HaiVuQuang/IPS_Firefighting_training_system/Documents/VuQuangNhatHai/DATN_VQNH_report_slide.pdf

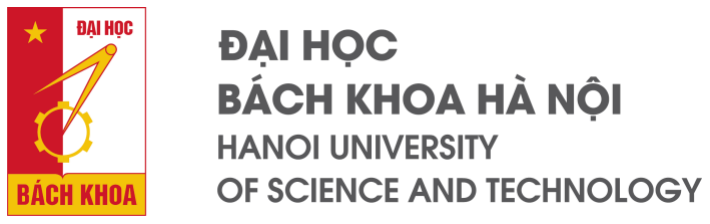
[picture p79: figure]

# THIẾT KẾ HỆ THỐNG HUẤN LUYỆN CHỮA CHÁY TRONG MÔI TRƯỜNG ẢO ỨNG DỤNG CÁC KỸ THUẬT ĐỊNH VỊ TRONG NHÀ

### Sinh viên: Vũ Quang Nhật Hải MSSV: 20222125 GVHD: TS. Hoàng Đức Chính

2

## Đề tài:

## MỤC LỤC

## 1. Tổng quan đề tài

## 2. Cơ sở lý thuyết và thuật toán định vị

## 3. Thiết kế - phát triển hệ thống

## 4. Thực nghiệm - đánh giá

## 5. Kết luận - Hướng phát triển

3

I.

# Tổng quan đề tài

## 1. TỔNG QUAN ĐỀ TÀI

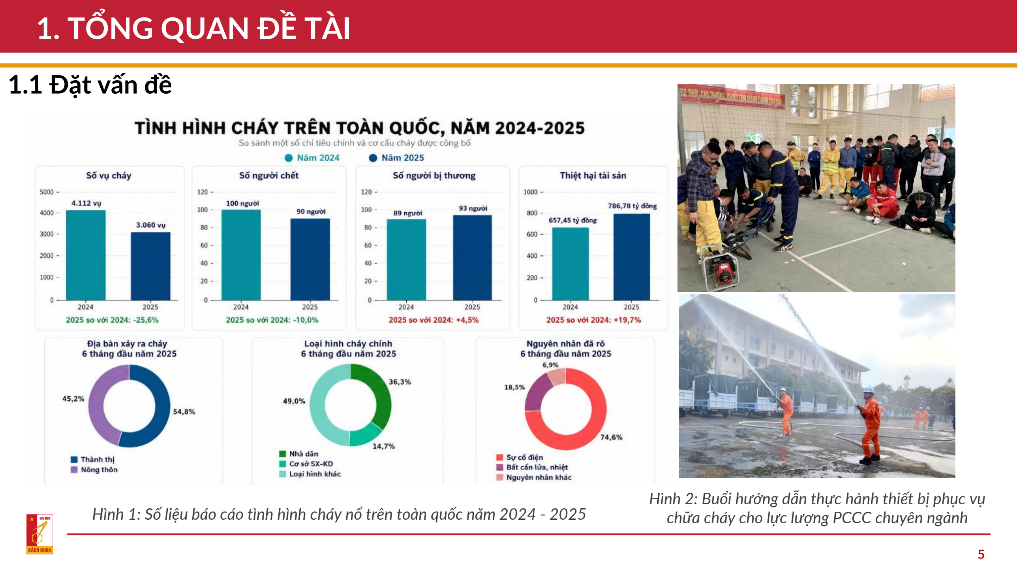
[picture p80: page 5]

5

### 1.1 Đặt vấn đề

Hình 1: Số liệu báo cáo tình hình cháy nổ trên toàn quốc năm 2024 - 2025

Hình 2: Buổi hướng dẫn thực hành thiết bị phục vụ chữa cháy cho lực lượng PCCC chuyên ngành

## 1. TỔNG QUAN ĐỀ TÀI

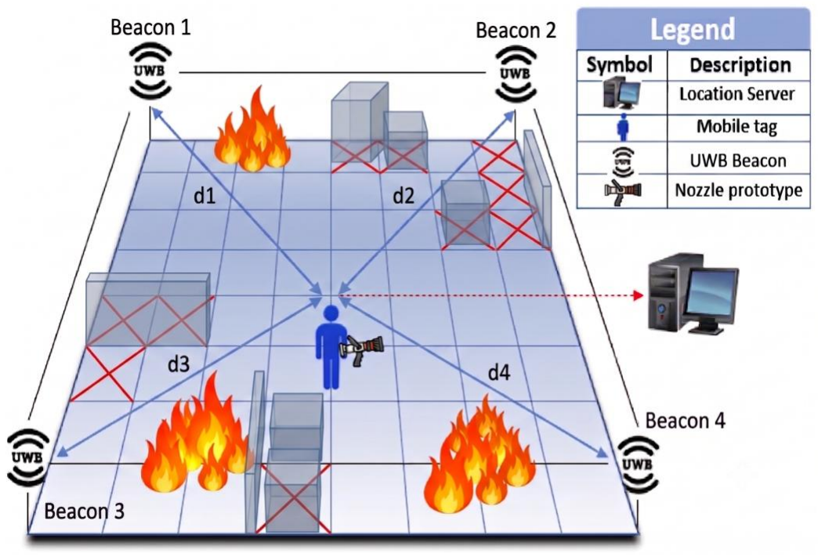
[picture p81: figure]

6

### 1.2 Mục tiêu và phạm vi đề tài

- Mục tiêu: Thiết kế, triển khai và thử nghiệm một hệ thống hỗ trợ huấn luyện chữa cháy dựa trên nền tảng mô phỏng
- Phạm vi đề tài:
- Nghiên cứu giải pháp theo dõi – định vị liên tục tọa độ quỹ đạo học viên theo thời gian thực
- Phát triển Prototype phần cứng dựa theo thiết bị chữa cháy thực tế, tích hợp cảm biến và cơ cấu chấp hành nhằm số hóa thao tác, phục vụ huấn luyện
- Xây dựng nền tảng phần mềm với các công cụ quản lý
tập trung giúp huấn luyện viên số hóa bản đồ, thiết
lập kịch bản huấn luyện và giám sát, đánh giá kết quả. | Hình 3: Sơ đồ ý tưởng thiết kế cho hệ thống huấn luyện mô phỏng

II.

# Cơ sở lý thuyết và thuật toán định vị

## 2. CƠ SỞ LÝ THUYẾT VÀ THUẬT TOÁN ĐỊNH VỊ

8

### 2.1 Thuật toán định vị đề xuất

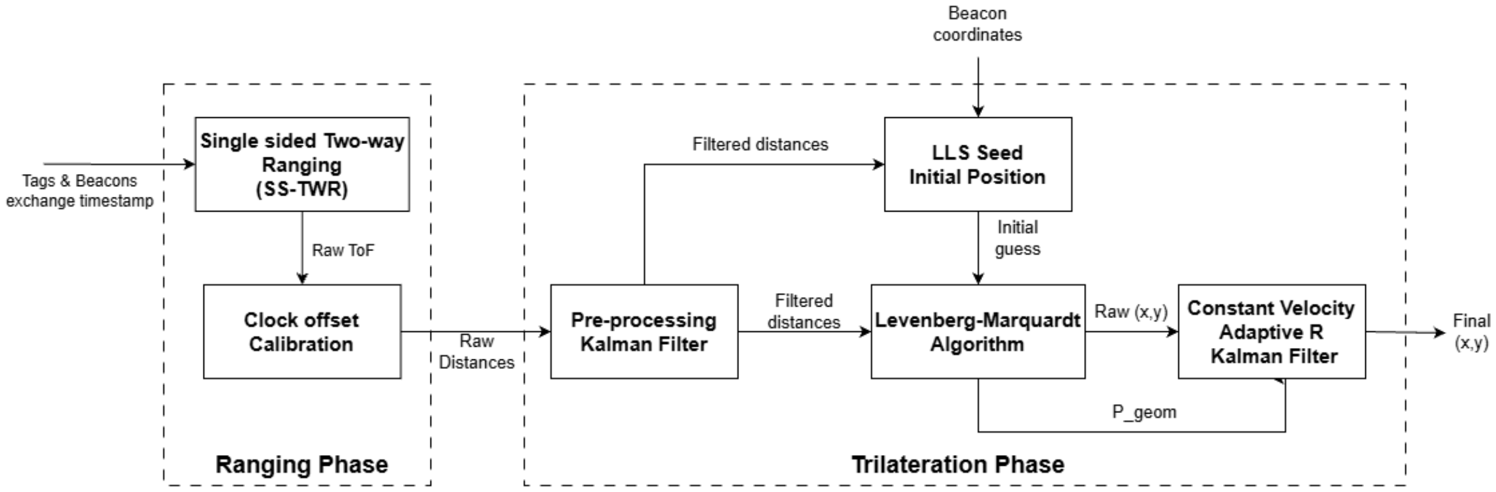
[picture p82: figure]

Hình 4: Các giai đoạn xử lý dữ liệu trong kiến trúc thuật toán định vị đề xuất

## 2. CƠ SỞ LÝ THUYẾT VÀ THUẬT TOÁN ĐỊNH VỊ

9

### 2.2 Kỹ thuật định tầm Single sided Two-way Ranging (SS-TWR)

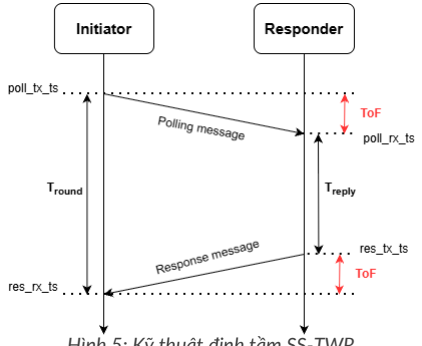
[picture p83: figure]

ClockOffsetRatio = carrier_integ ×

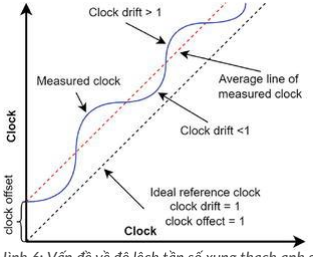
[picture p84: figure]

FREQ_OFFSET × HERTZ_TO_PPM_MULTIPLIER 1.0 × 10⁶

ToF =

resp_rx_ts − poll_tx_ts − resp_tx_ts − poll_rx_ts × 1.0 − ClockOffsetRatio 2

Hình 5: Kỹ thuật định tầm SS-TWR

Hình 6: Vấn đề về độ lệch tần số xung thạch anh giữa thiết bị phát/ thu

## 2. CƠ SỞ LÝ THUYẾT VÀ THUẬT TOÁN ĐỊNH VỊ

10

❖ Pha Dự báo (State Prediction):
- Dự báo trạng thái:
X෠

k|k−1 = F . X෠
k−1|k−1
- Dự báo ma trận sai số:
P෠

k|k−1 = F .X෠
k−1|k−1. F

T + Q
❖ Pha Cập nhật (Update Phase):
Đo đạc dữ liệu khoảng cách thô zk ở chu kỳ hiện tại để hiệu chỉnh lại dự báo.
- Kalman Gain:

Kk =

Pk|k−1.H

T
(H. Pk|k−1.HT) + R
- Cập nhật trạng thái:
X෠

k|k = X෠

k|k−1 − Kk. (zk − H. X෠
k|k−1)
- Cập nhật ma trận sai số:
P෠

k|k = (I − Kk.H). P෠
k|k−1

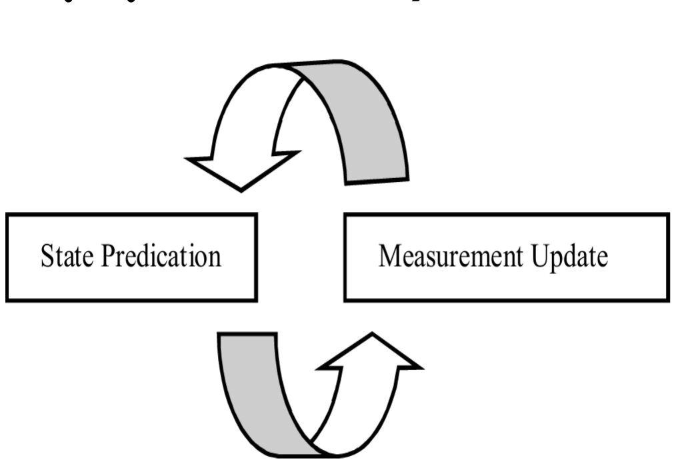
[picture p85: figure]

❖ Mô hình toán học :

Xk =

dk
dሶ
k

, F =

1 Δt
0 1

,

Q = σa

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
, | R = σz
| 2

### 2.3 Bộ lọc tiền xử lý Kalman Filter

Hình 7: Giai đoạn bộ lọc Kalman Filter

## 2. CƠ SỞ LÝ THUYẾT VÀ THUẬT TOÁN ĐỊNH VỊ

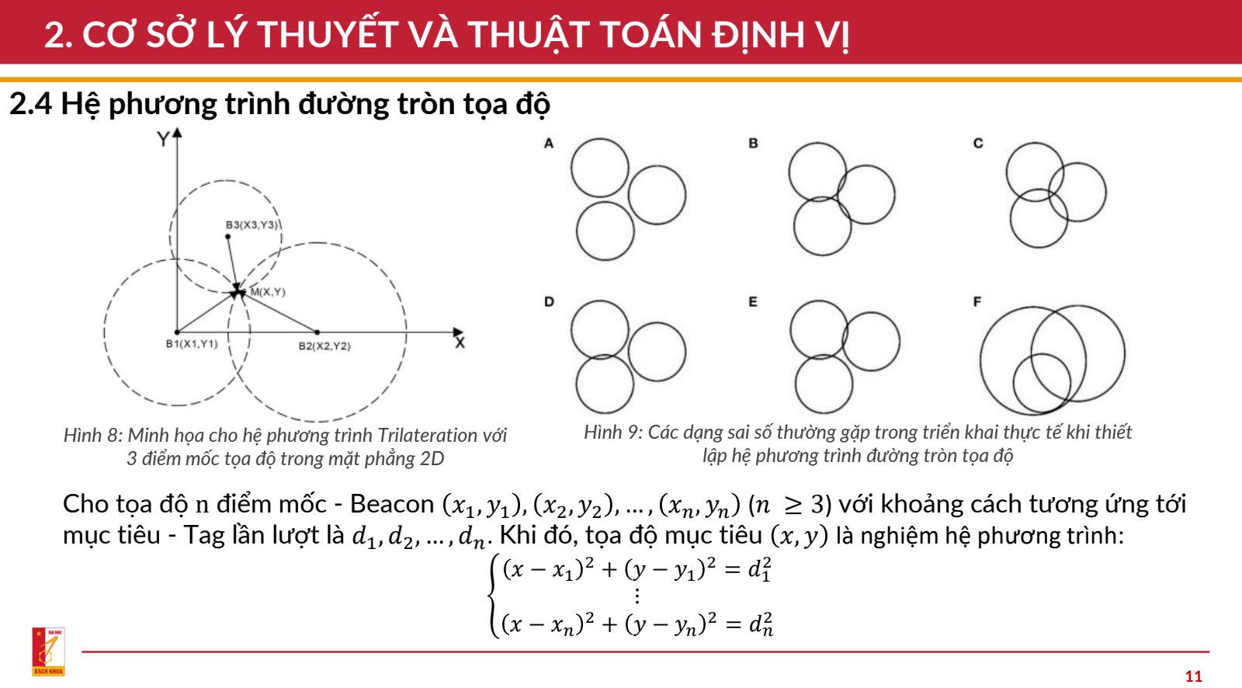
[picture p86: page 11]

11

Cho tọa độ n điểm mốc - Beacon x1, y1 , x2, y2 , … , xn, yn (n ≥ 3) với khoảng cách tương ứng tới mục tiêu - Tag lần lượt là d1, d2, … , dn. Khi đó, tọa độ mục tiêu x, y là nghiệm hệ phương trình:
ቐ
x − x1

2 + y − y1

2 = d1

2
⋮
x − xn

2 + y − yn

2 = dn

2

### 2.4 Hệ phương trình đường tròn tọa độ

Hình 8: Minh họa cho hệ phương trình Trilateration với 3 điểm mốc tọa độ trong mặt phẳng 2D

Hình 9: Các dạng sai số thường gặp trong triển khai thực tế khi thiết lập hệ phương trình đường tròn tọa độ

## 2. CƠ SỞ LÝ THUYẾT VÀ THUẬT TOÁN ĐỊNH VỊ

12

Hàm mục tiêu của bài toán định vị đặt ra nhằm cực tiểu hóa tổng bình phương các phần dư giữa khoảng cách lý thuyết và thực tế:

f x, y = ෍

i=1

n
x − xi

2 + y − yi

2 − di

2
→ min
Trong đó:
- x − xi

2 + y − yi

2 : Khoảng cách lý thuyết từ vị trí mục tiêu (x, y) đến Beacon thứ i.
- di

: Khoảng cách thực tế đo được từ Tag và Beacon thứ i

### 2.5 Bài toán Tối ưu Bình phương tối thiểu

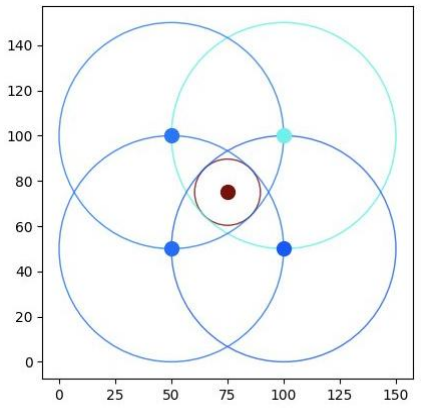
[picture p87: figure]

Hình 10: Bài toán tối ưu bình phương tối thiểu

## 2. CƠ SỞ LÝ THUYẾT VÀ THUẬT TOÁN ĐỊNH VỊ

13

Thuật toán Levenberg–Marquardt tìm bước nhảy ΔP Δx, Δy bằng cách giải hệ phương trình tuyến tính:
J

T
J + λI ΔP = −J

T
r

J =

∂r1
∂x

∂r1
∂y
⋮ | ⋮
∂rN ∂x | ∂r1
| ∂y

∂ri
∂x

=

xk − xi
xk − xi

2 + yk − yi

2
∂ri
∂y

=

yk − yi
xk − xi

2 + yk − yi

2

Với | trong đó

Sau mỗi tính toán bước nhảy ΔP Δx, Δy , tiến hành cập nhật tọa độ mới:
Xk+1 = Xk + ΔP
Vòng lặp sẽ dừng lại khi thỏa mãn một trong các điều kiện:
- Bước nhảy ΔP quá nhỏ | ΔP | < ε1
- Sự thay đổi của tổng bình phương giữa 2 bước lặp không đáng kể | S Xk+1 − S Xk | < ε2
- Số vòng lặp vượt quá giới hạn cho phép k > kmax
Kết quả tại thời điểm dừng lại chính là kết quả thu được khi triển khai thuật toán

### 2.6 Thuật toán lặp Levenberg-Marquardt

## 2. CƠ SỞ LÝ THUYẾT VÀ THUẬT TOÁN ĐỊNH VỊ

14

❖ Mô hình toán học:

Xk =

xk
yk
vx,k
vy,k

, F =

1 0 Δt | 0
0 1 | 0 | Δt
0 0 | 1 | 0
0 0 | 0 | 1

,

Q = σa

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
0 | Δt
2 | 0

0

Δt

3
2

0 Δt

2

,

Rk= λ ⋅ Pgeom

❖ Pha Dự báo (State Prediction):
- Dự báo trạng thái:
X෠

k|k−1 = F . X෠
k−1|k−1
- Dự báo ma trận sai số:
P෠

k|k−1 = F . X෠
k−1|k−1. F

T + Q
❖ Pha Cập nhật (Update Phase):
- Cập nhật ma trận nhiễu đo lường

Rk = λ ⋅ Pgeom
- Kalman Gain:

Kk =

Pk|k−1.H

T
(H. Pk|k−1.HT) + R
- Cập nhật trạng thái:
X෠

k|k = X෠

k|k−1 − Kk. (zk − H.X෠
k|k−1)
- Cập nhật ma trận sai số:
P෠

k|k = (I − Kk.H). P෠
k|k−1

### 2.7 Bộ lọc Adaptive R Kalman Filter

III.

# Thiết kế - Phát triển hệ thống

## 3. THIẾT KẾ - PHÁT TRIỂN HỆ THỐNG

16

### 3.1 Tổng quan thành phần hệ thống

Mạng lưới Điểm neo cố định (UWB Beacons):
- Master Beacon: Đóng vai trò Coordinator - đồng bộ chu kỳ các pha định tầm, phân chia khe thời gian (TDMA) và gom tập trung dữ liệu định tầm trong mạng đẩy lên Server.
- Slave Beacons: Các điểm tham chiếu cố định. Giao tiếp với Tag qua sóng UWB để đo khoảng cách thô

Thiết bị mục tiêu (Tag – Thiết bị chữa cháy mô phỏng):
- Module UWB liên tục thu/phát tín hiệu định tầm với các Beacons.
- Tích hợp cảm biến và cơ cấu chấp hành để số hóa tương tác
- Giao diện màn hình (TFT) giúp người dùng theo dõi tiến trình

Máy chủ trung tâm (Server):
- Xử lý tọa độ 2D của mục tiêu từ dữ liệu các bộ khoảng cách thô
- Mô phỏng tính logic tương tác vật lý giữa hành động dập lửa và đám cháy ảo.
- Cung cấp công cụ cho Huấn luyện viên tạo bản đồ, kịch bản cháy và giám sát thời gian thực.

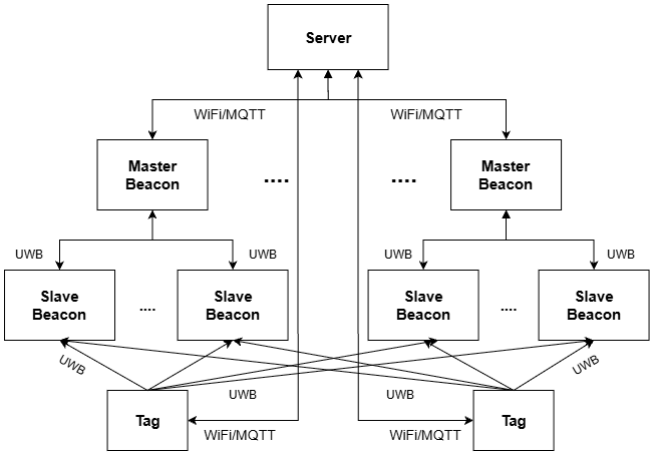
[picture p88: figure]

Hình 11: Sơ đồ tổng quan các thành phần trong hệ thống

## 3. THIẾT KẾ - PHÁT TRIỂN HỆ THỐNG

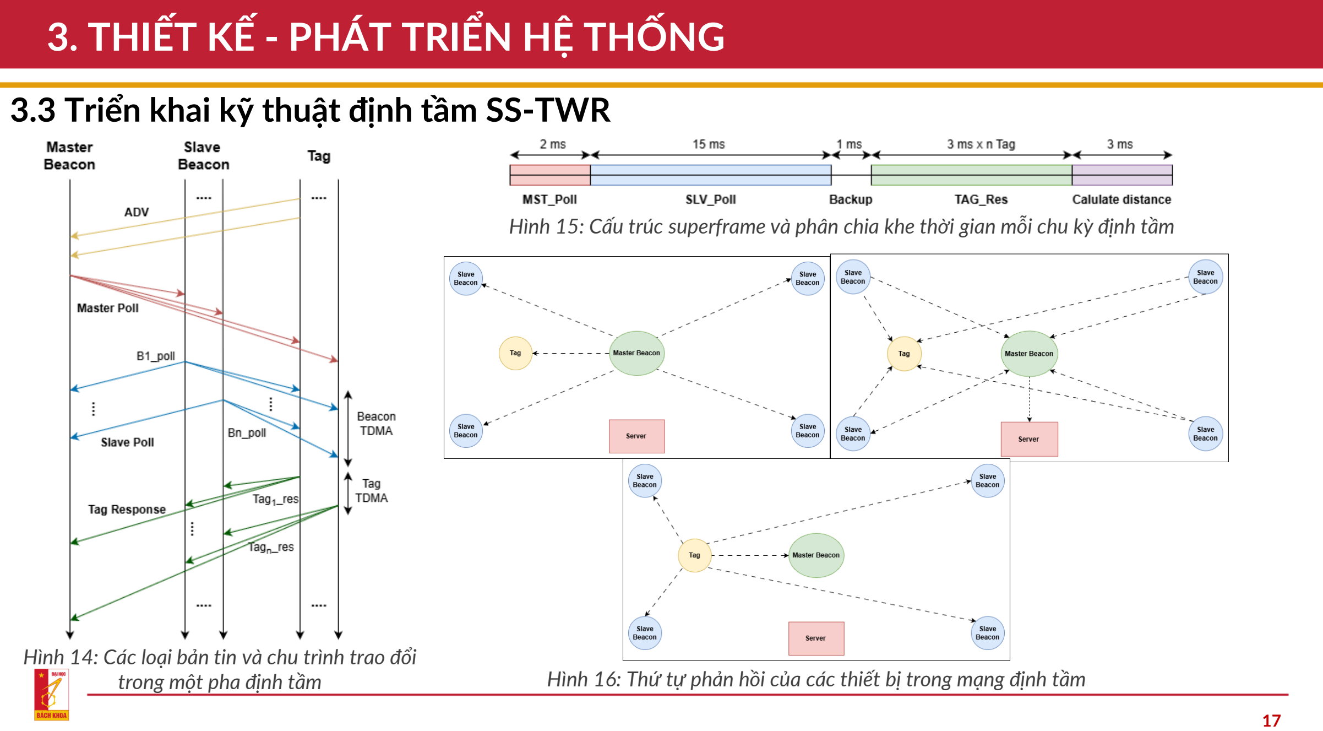
[picture p89: page 17]

17

### 3.3 Triển khai kỹ thuật định tầm SS-TWR

Hình 14: Các loại bản tin và chu trình trao đổi trong một pha định tầm

Hình 15: Cấu trúc superframe và phân chia khe thời gian mỗi chu kỳ định tầm

Hình 16: Thứ tự phản hồi của các thiết bị trong mạng định tầm

## 3. THIẾT KẾ - PHÁT TRIỂN HỆ THỐNG

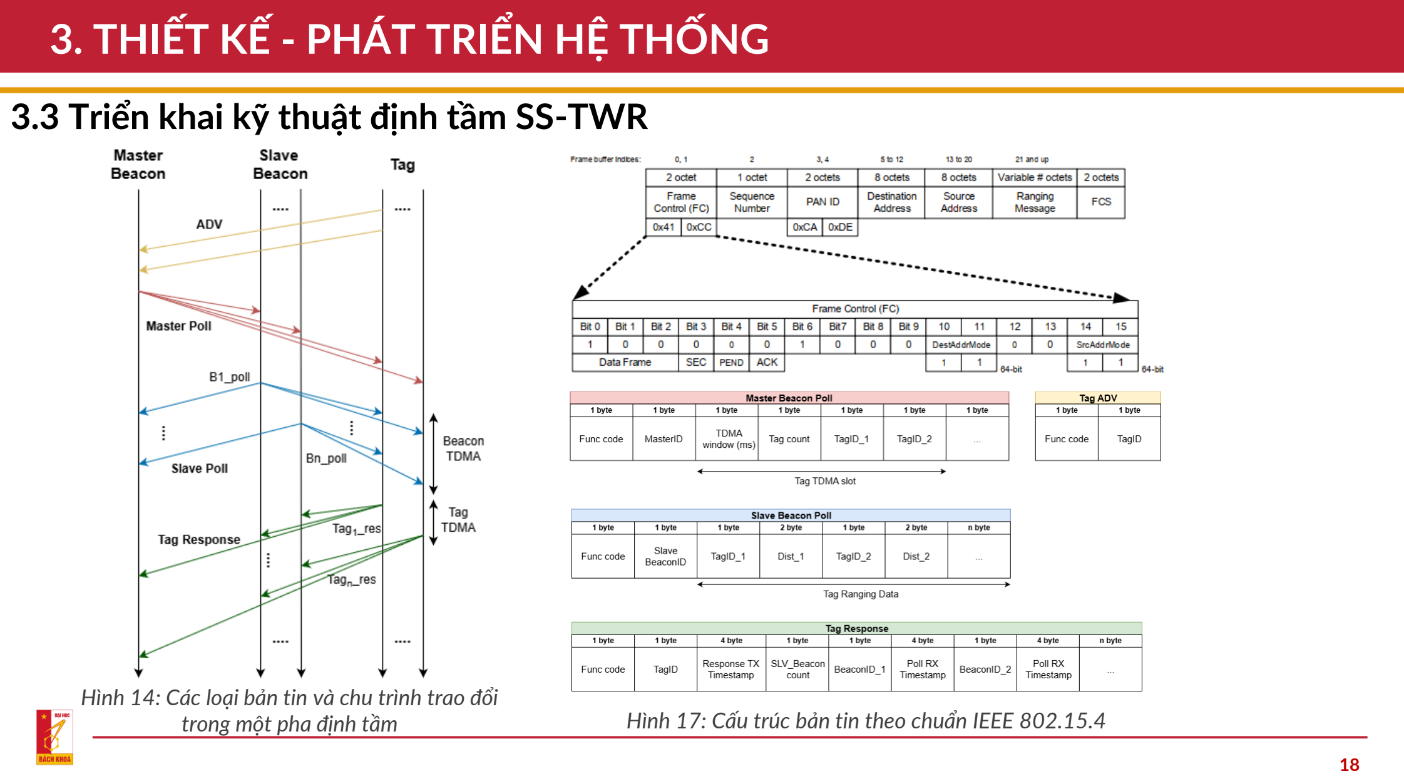
[picture p90: page 18]

18

### 3.3 Triển khai kỹ thuật định tầm SS-TWR

Hình 14: Các loại bản tin và chu trình trao đổi
trong một pha định tầm | Hình 17: Cấu trúc bản tin theo chuẩn IEEE 802.15.4

## 3. THIẾT KẾ - PHÁT TRIỂN HỆ THỐNG

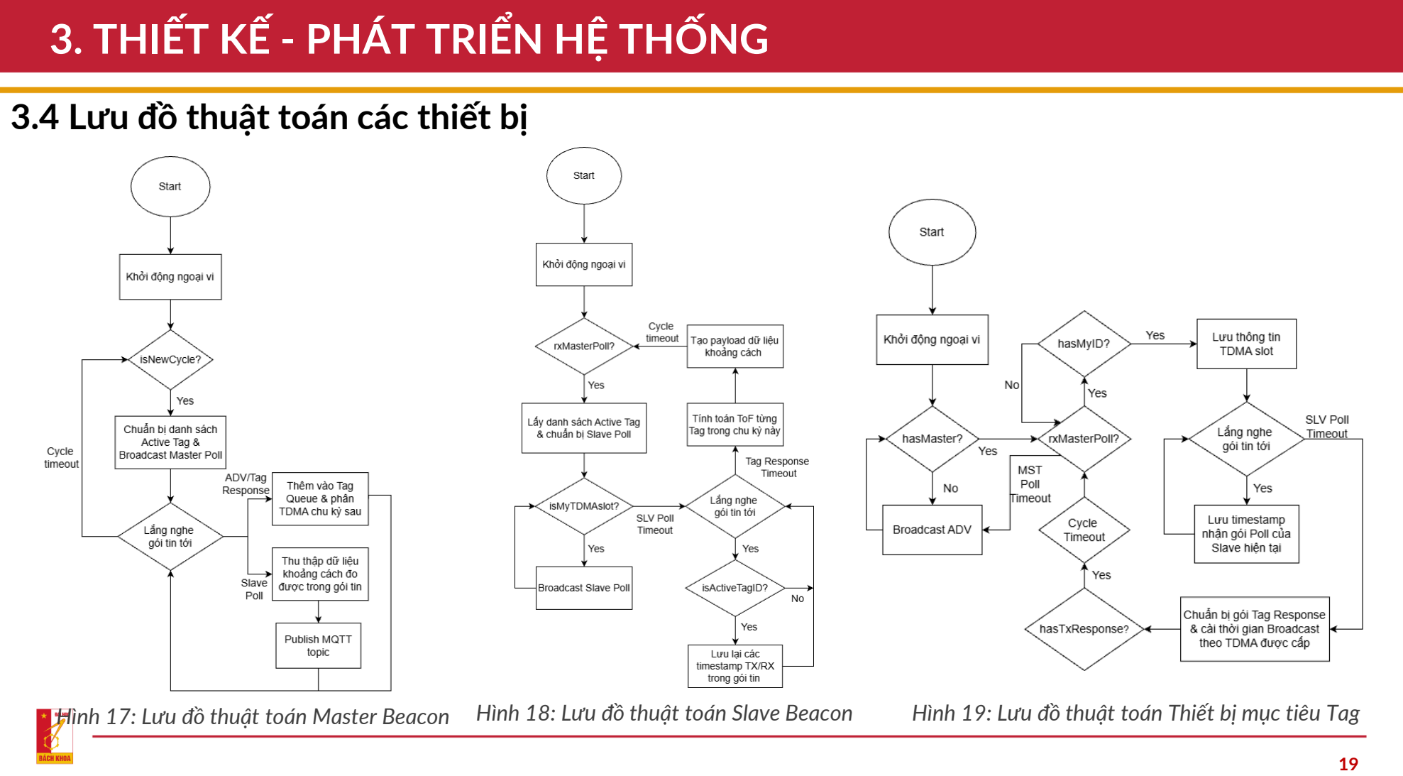
[picture p91: page 19]

19

### 3.4 Lưu đồ thuật toán các thiết bị

Hình 17: Lưu đồ thuật toán Master Beacon Hình 18: Lưu đồ thuật toán Slave Beacon Hình 19: Lưu đồ thuật toán Thiết bị mục tiêu Tag

## 3. THIẾT KẾ - PHÁT TRIỂN HỆ THỐNG

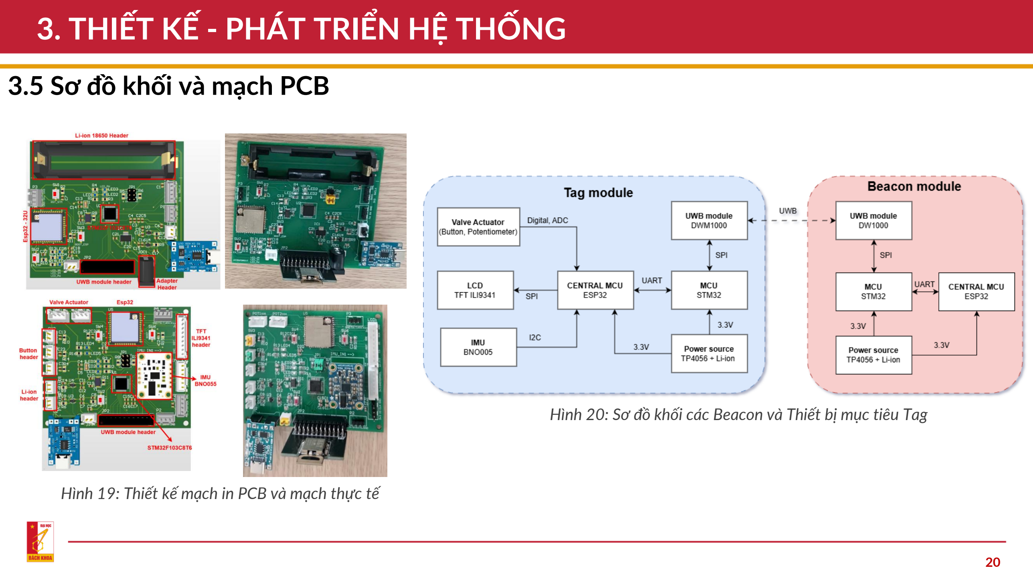
[picture p92: page 20]

20

### 3.5 Sơ đồ khối và mạch PCB

Hình 20: Sơ đồ khối các Beacon và Thiết bị mục tiêu Tag

Hình 19: Thiết kế mạch in PCB và mạch thực tế

## 3. THIẾT KẾ - PHÁT TRIỂN HỆ THỐNG

21

### 3.7 Luồng khai báo và động bộ thiết bị huấn luyện

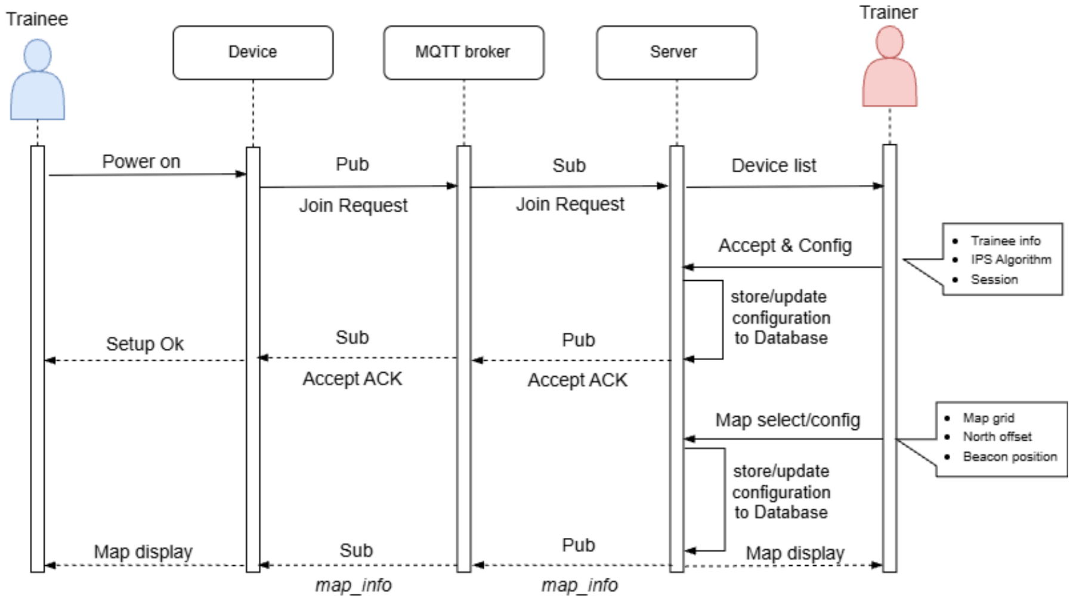
[picture p93: figure]

Hình 21: Sequence diagram luồng khai báo và đồng bộ dữ liệu bài tập giữa Thiết bị huấn luyện và Server

## 3. THIẾT KẾ - PHÁT TRIỂN HỆ THỐNG

22

### 3.8 Luồng vận hành bài tập huấn luyện

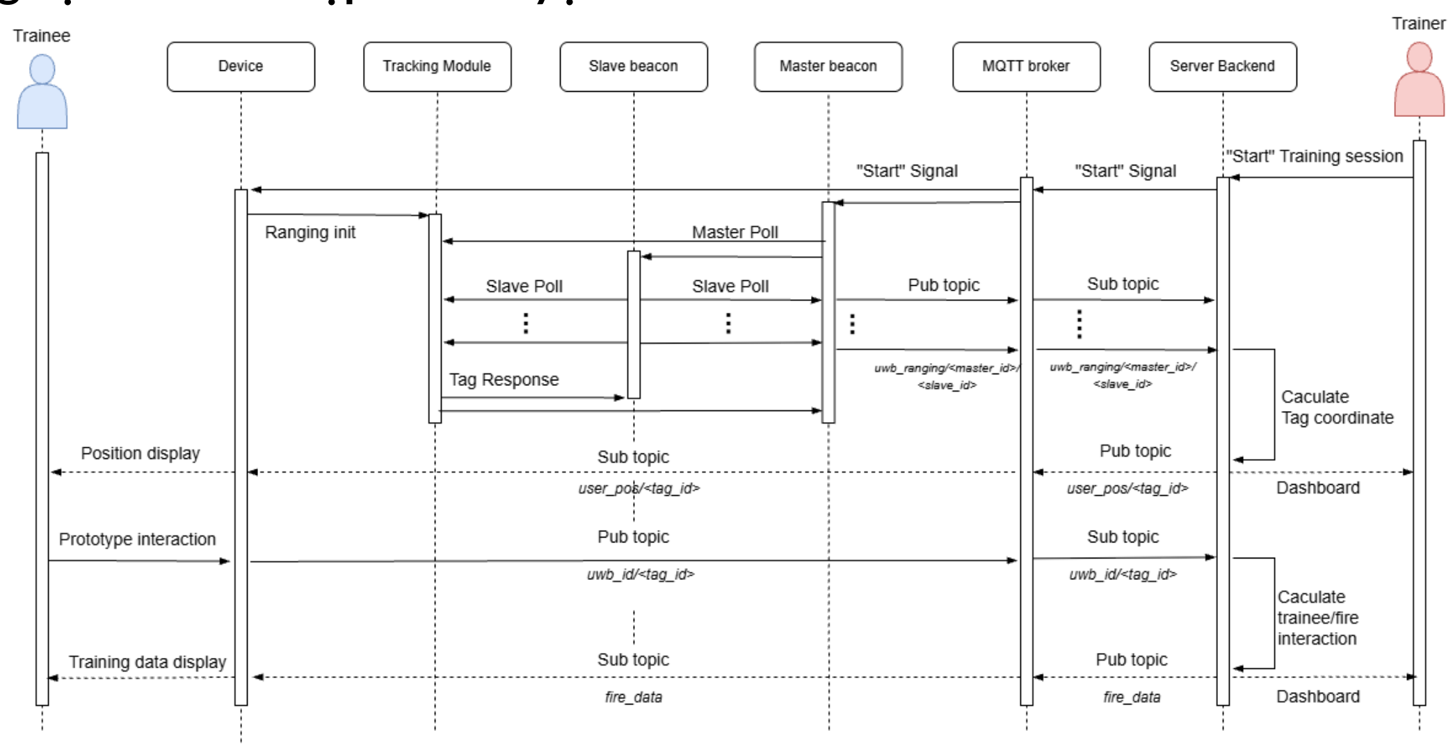
[picture p94: figure]

Hình 22: Sequence diagram luồng trao đổi dữ liệu trong quá trình vận hành bài tập

## 3. THIẾT KẾ - PHÁT TRIỂN HỆ THỐNG

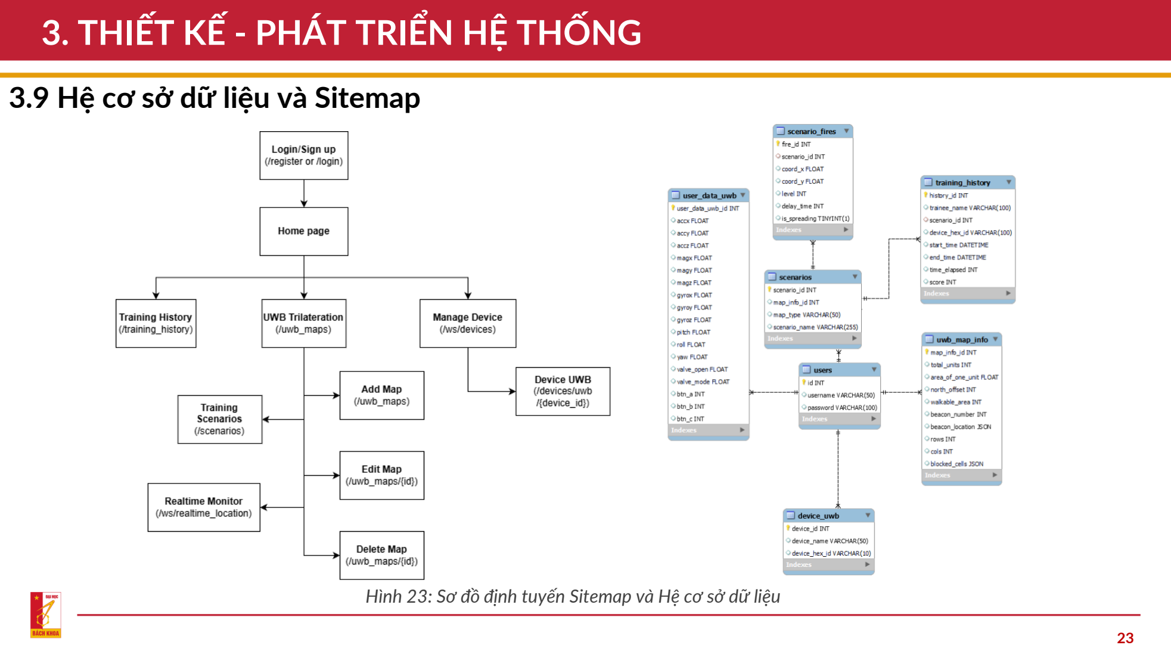
[picture p95: page 23]

23

### 3.9 Hệ cơ sở dữ liệu và Sitemap

Hình 23: Sơ đồ định tuyến Sitemap và Hệ cơ sở dữ liệu

## 3. THIẾT KẾ - PHÁT TRIỂN HỆ THỐNG

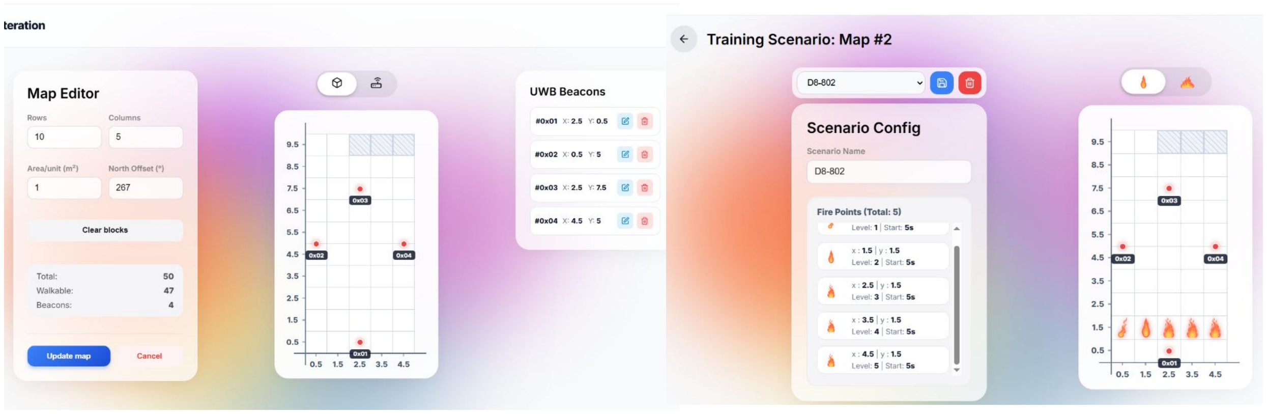
[picture p96: figure]

24

### 3.10 Công cụ tạo/điều chỉnh bản đồ và kịch bản huấn luyện

Hình 24: Giao diện cấu hình môi trường huấn luyện | Hình 25: Giao diện cấu hình các ngọn lửa và kịch bản huấn luyện

## 3. THIẾT KẾ - PHÁT TRIỂN HỆ THỐNG

25

### 3.11 Dashboard vận hành bài tập trực tiếp

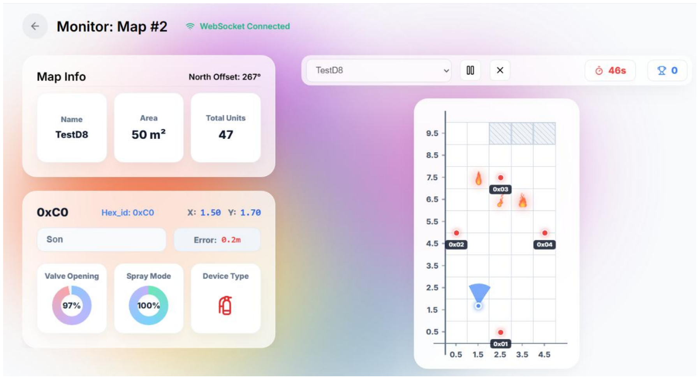
[picture p97: figure]

Hình 26: Giao diện Dashboard vận hành bài tập trực tiếp

IV.

# Thực nghiệm – Đánh giá

## 4. THỰC NGHIỆM - ĐÁNH GIÁ

27

### 4.1 Prototype thiết bị huấn luyện

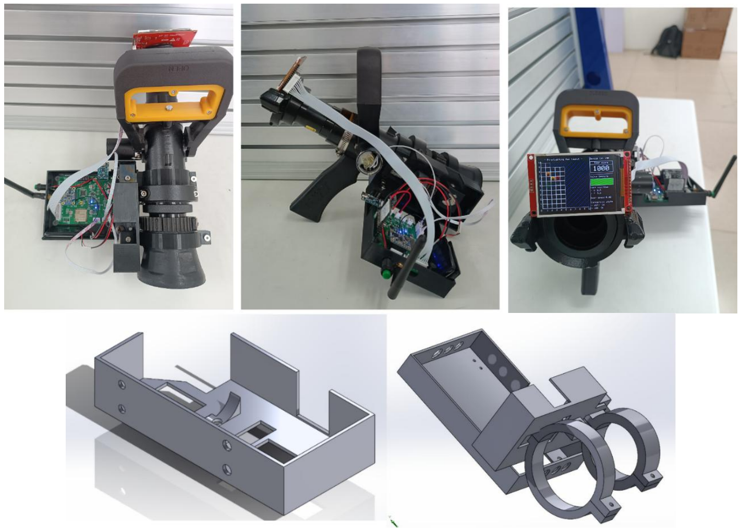
[picture p98: figure]

Hình 27: Triển khai Prototype thiết bị huấn luyện cho lăng phun chữa cháy

## 4. THỰC NGHIỆM - ĐÁNH GIÁ

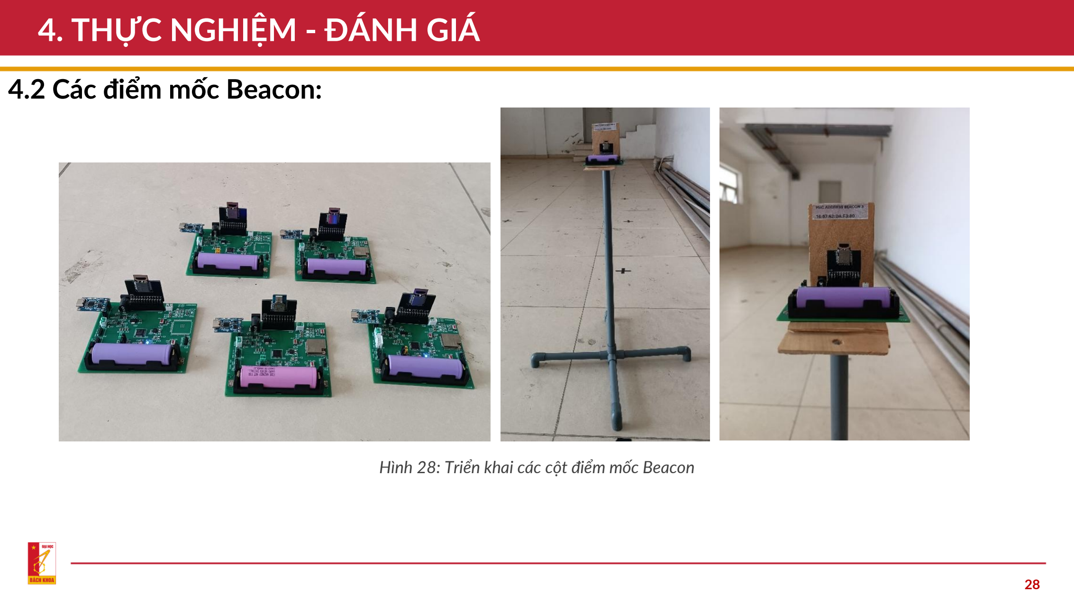
[picture p99: page 28]

28

### 4.2 Các điểm mốc Beacon:

Hình 28: Triển khai các cột điểm mốc Beacon

## 4. THỰC NGHIỆM - ĐÁNH GIÁ

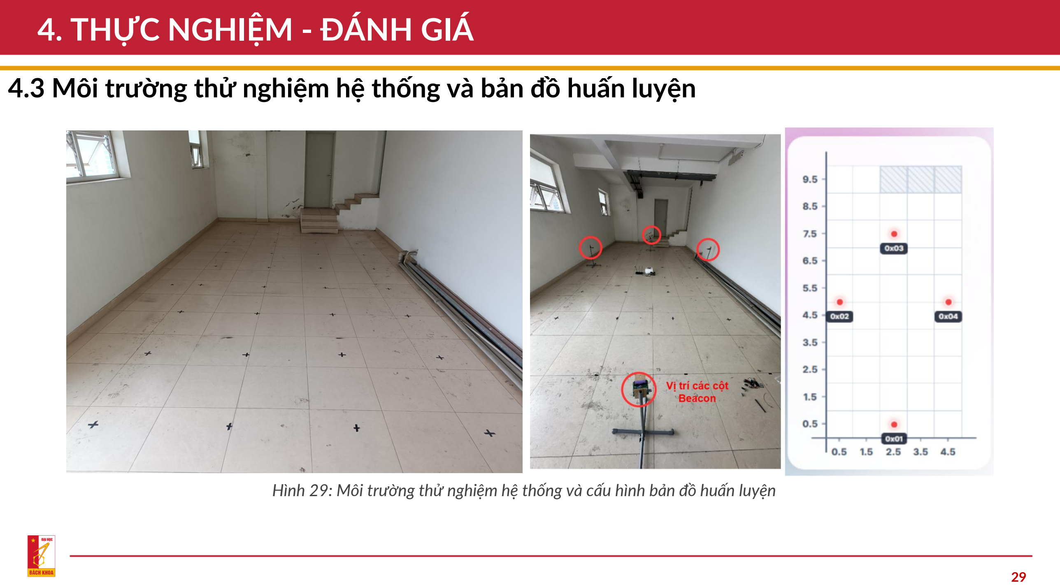
[picture p100: page 29]

29

### 4.3 Môi trường thử nghiệm hệ thống và bản đồ huấn luyện

Hình 29: Môi trường thử nghiệm hệ thống và cấu hình bản đồ huấn luyện

## 4. THỰC NGHIỆM - ĐÁNH GIÁ

30

Phương pháp định vị | PDR + CNN | Tranformer | UWB
Sai số trung bình (m) | 0,537 | 0,42 | 0,38

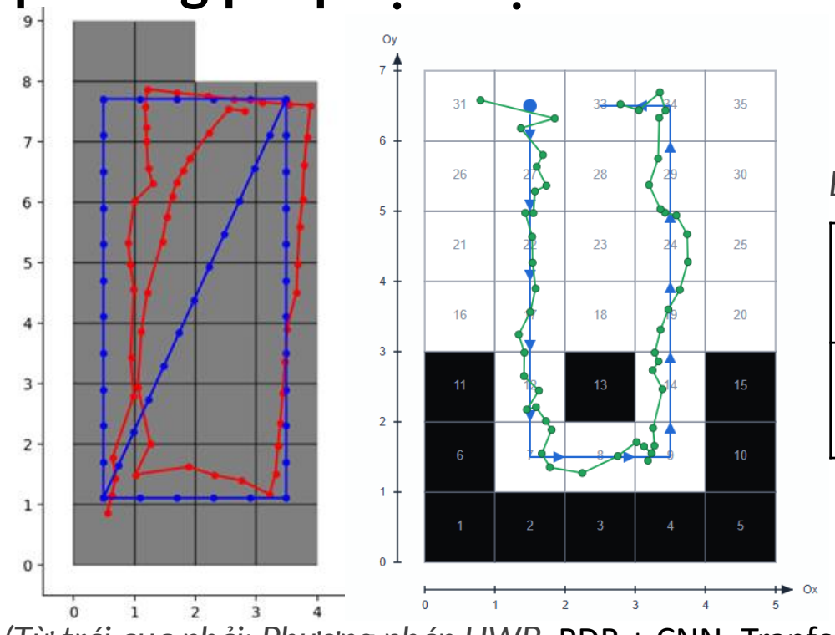
[picture p101: figure]
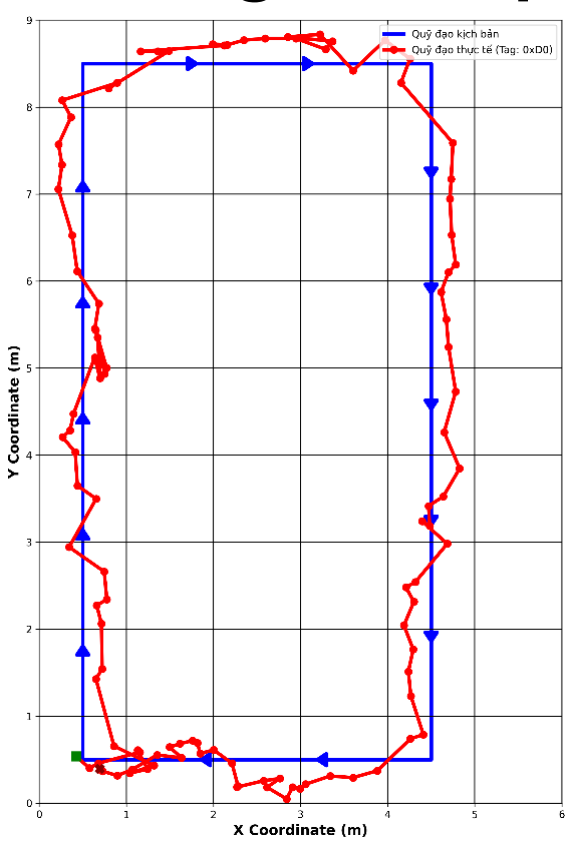
[picture p102: figure]

1. Pham Xuan Hieu, Nguyen Trung Kien, Vu Quang Nhat Hai, Nguyen Van Hung, Nguyen Xuan Son, Hoang Duc Chinh, “Indoor Positioning via Wi-Fi and Geomagnetic field using CNN and Kalman-based PDR refinement.” 2025 Asia Meeting on Environment and Electrical Engineering (EEE-AM25), 05th -
07th November 2025. Hanoi, Vietnam. Published. 10. (https://doi.org/10.1109/EEE-AM66675.2025.11473930)1109 (https://doi.org/10.1109/EEE-AM66675.2025.11473930)/EEE (https://doi.org/10.1109/EEE-AM66675.2025.11473930)- (https://doi.org/10.1109/EEE-AM66675.2025.11473930)AM (https://doi.org/10.1109/EEE-AM66675.2025.11473930)66675. (https://doi.org/10.1109/EEE-AM66675.2025.11473930)2025. (https://doi.org/10.1109/EEE-AM66675.2025.11473930)11473930 (https://doi.org/10.1109/EEE-AM66675.2025.11473930)
2. Nguyen Trung Kien, Nguyen Van Hung, Vu Quang Nhat Hai, Nguyen Xuan Son, Hoang Duc Chinh, “An Improved Indoor Positioning System based on Wi-Fi, BLE, and IMU Fusion using Attention Mechanism” the 8

th international conference on green technology and sustainable development (GTSD 2026), 30th – 31st July 2026. Accepted

### 4.4 Đánh giá kết quả phương pháp định vị

Hình 30: So sánh kết quả định vị (Từ trái qua phải: Phương pháp UWB, PDR + CNN, Tranformer)

Bảng 1: So sánh độ chính xác giữa các giải pháp định vị IPS

## 4. THỰC NGHIỆM - ĐÁNH GIÁ

31

### 4.5 Demo tính năng hệ thống huấn luyện chữa cháy

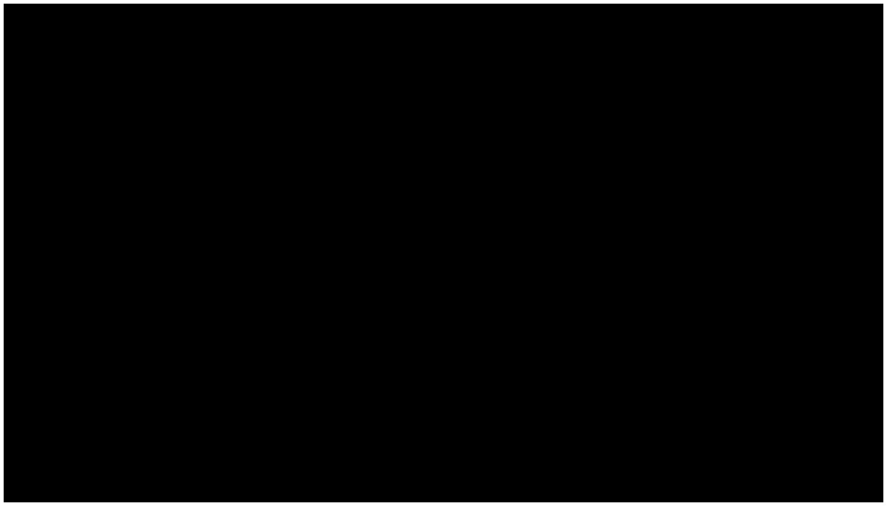
[picture p103: figure]

## 5. KẾT LUẬN – HƯỚNG PHÁT TRIỂN

32

Kết quả đạt được:
- Triển khai thành công hệ thống định vị trong nhà dựa trên công nghệ UWB.
- Phần cứng: Hoàn thiện Prototype lăng phun chữa cháy mô phỏng, tích hợp cảm biến & cơ cấu chấp hành.
- Phần mềm: Xây dựng Web App & Server quản lý, giám sát bài tập thời gian thực.
- Học thuật: Công bố 02 bài báo khoa học quốc tế (EEE-AM25, GTSD 2026).

Tồn tại & Hướng phát triển đề tài:
- Mô hình định vị: Giới hạn mặt phẳng 2D. Mở rộng thuật toán lên không gian 3D: hỗ trợ tư thế quỳ, trườn hay địa hình phức tạp hơn như leo cầu thang,..
- Tốc độ đáp ứng: Xảy ra độ trễ khi di chuyển nhanh, cần tối ưu chu trình gói tin & nâng cấp bộ lọc phù hợp với đặc tính bài toán thay thế Kalman Filter.
- Vận hành & Trải nghiệm: Mô hình cháy đơn giản, thời lượng pin ngắn (2-3h), setup phức tạp. Cần tối ưu năng lượng, tích hợp App di động & tự động hóa cấu hình.

# THANK YOU !

33

## 2. CƠ SỞ LÝ THUYẾT VÀ THUẬT TOÁN ĐỊNH VỊ - SLIDE BỔ TRỢ

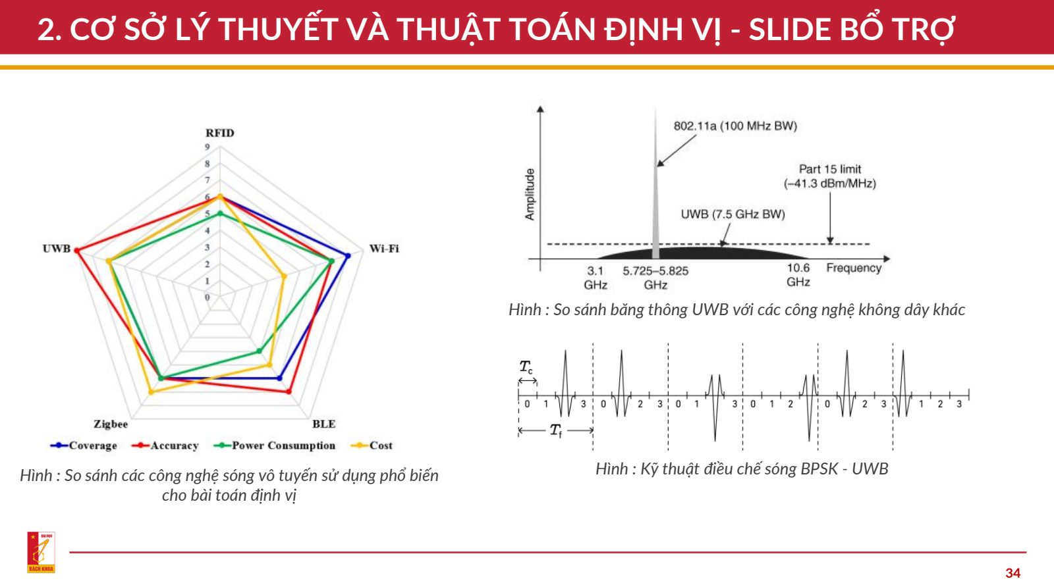
[picture p104: page 34]

34

Hình : So sánh các công nghệ sóng vô tuyến sử dụng phổ biến cho bài toán định vị

Hình : So sánh băng thông UWB với các công nghệ không dây khác

Hình : Kỹ thuật điều chế sóng BPSK - UWB

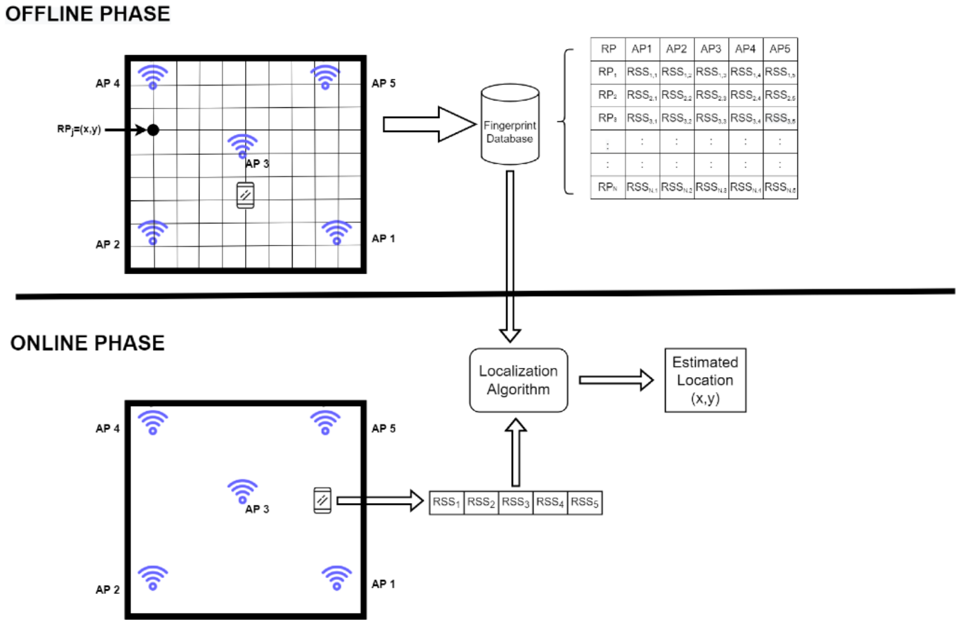
[picture p105: figure]

35

## 2. THIẾT KẾ - TRIỂN KHAI HỆ THỐNG

### ❖ Thuật toán CNN dựa trên bản đồ tín hiệu

Offline Phase :
- Chia khu vực huấn luyện thành các ô
lưới.
- Tại mỗi ô thiết bị thu thập RSSI từ các điểm phát đặt cố định.
- Huấn luyện mô hình học máy từ cơ sở dữ liệu.

Online Phase :
- Thiết bị thu giá trị RSSI hiện tại.
- Server tính toán vị trí từ kết quả mô hình học máy.

## 3. THIẾT KẾ - PHÁT TRIỂN HỆ THỐNG – SLIDE BỔ TRỢ

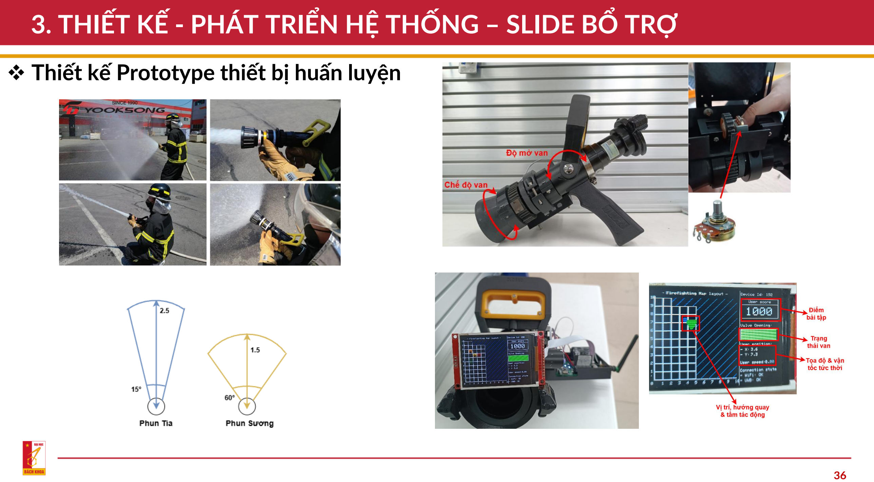
[picture p106: page 36]

36

### ❖ Thiết kế Prototype thiết bị huấn luyện

## 3. THIẾT KẾ - PHÁT TRIỂN HỆ THỐNG – SLIDE BỔ TRỢ

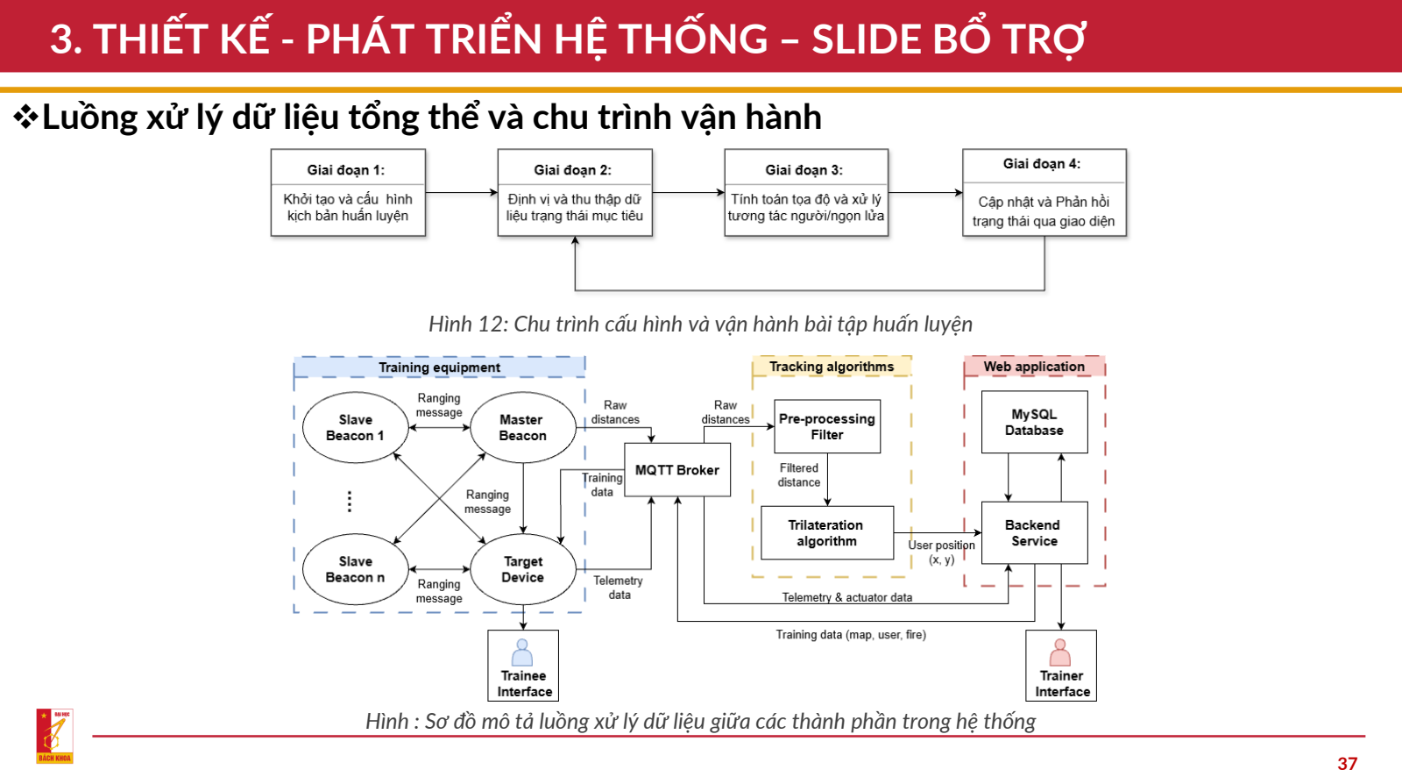
[picture p107: page 37]

37

### ❖Luồng xử lý dữ liệu tổng thể và chu trình vận hành

Hình 12: Chu trình cấu hình và vận hành bài tập huấn luyện

Hình : Sơ đồ mô tả luồng xử lý dữ liệu giữa các thành phần trong hệ thống

## 3. THIẾT KẾ - PHÁT TRIỂN HỆ THỐNG

38

### 3.8 Kiến trúc module chức năng Server quản lý và vận hành

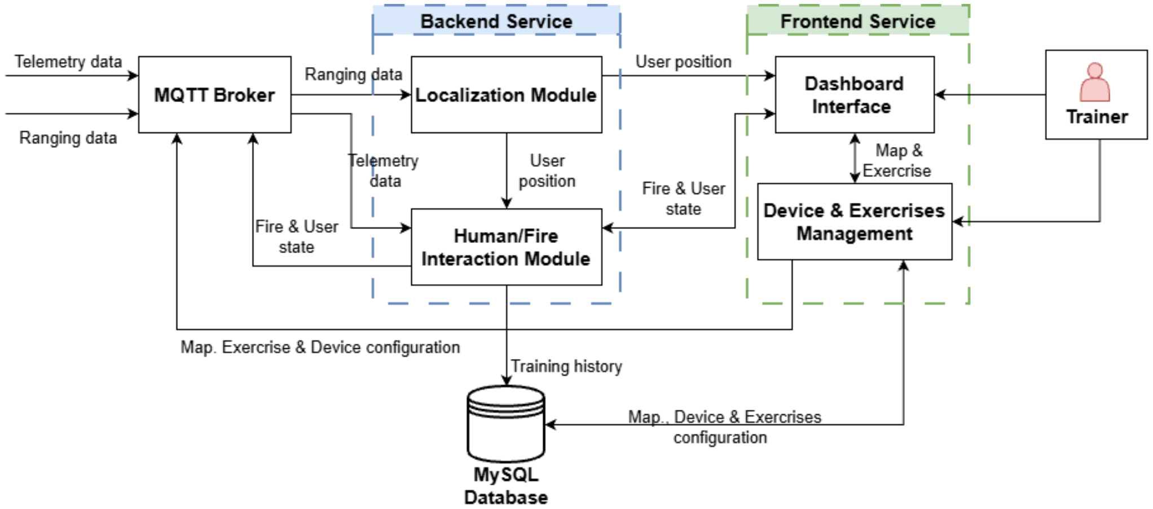
[picture p108: figure]

Hình : Kiến trúc các khối module chức năng Server quản lý & vận hành

## 3. THIẾT KẾ - PHÁT TRIỂN HỆ THỐNG – SLIDE BỔ TRỢ

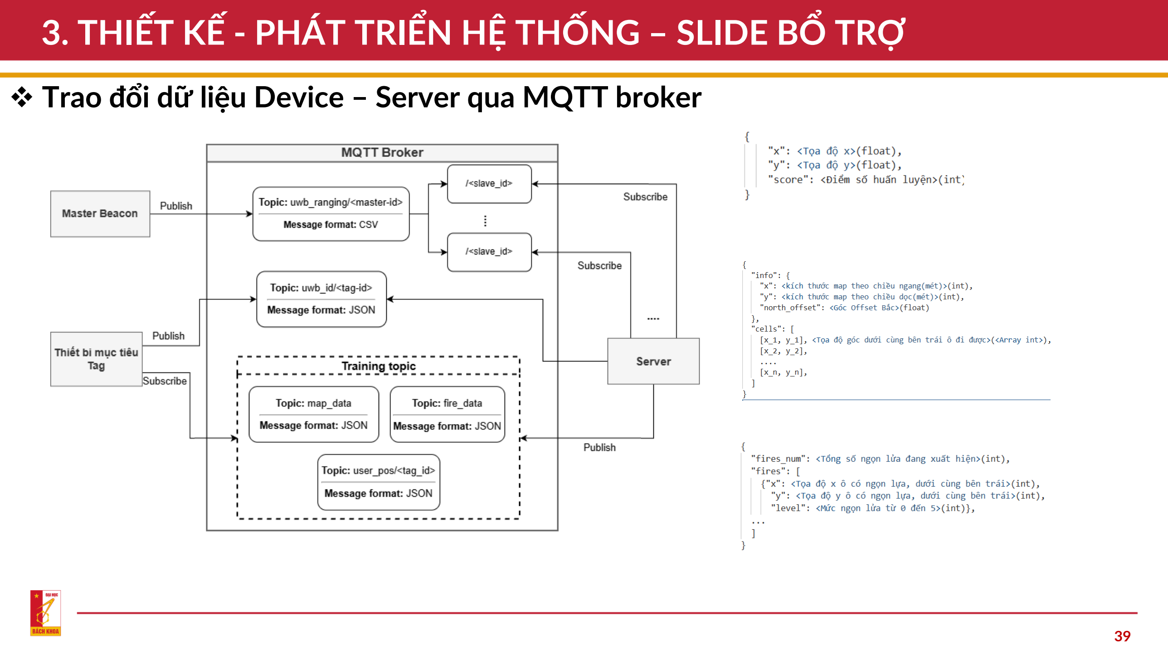
[picture p109: page 39]

39

### ❖ Trao đổi dữ liệu Device – Server qua MQTT broker
