HaiVuQuang/IPS_Firefighting_training_system/Documents/Results/ground_truth.csv

x | y
0.5 | 0.5
0.5 | 8.5
4.5 | 8.5
4.5 | 0.5
0.5 | 0.5
