HaiVuQuang/IPS_Firefighting_training_system/Documents/Results/trajectory_log.csv

timestamp | tag_id | x | y | type
1782448637.6064105 | 0xD0 | 0.4263626124867877 | 0.5364312654712992 | UWB
1782448639.3404377 | 0xD0 | 0.5770589002268893 | 0.4017840742273196 | UWB
1782448639.7701082 | 0xD0 | 0.6786103546507455 | 0.4586580889403546 | UWB
1782448641.6382086 | 0xD0 | 1.154772449405638 | 0.5846201618117032 | UWB
1782448642.7223544 | 0xD0 | 1.129272951162421 | 0.6099821786009456 | UWB
1782448643.6451108 | 0xD0 | 1.2426711189839292 | 0.3906397395850794 | UWB
1782448644.7658212 | 0xD0 | 1.0385502052711728 | 0.3435374181765395 | UWB
1782448646.4053411 | 0xD0 | 1.316666837018793 | 0.4326336203453738 | UWB
1782448648.2631476 | 0xD0 | 0.858022369782768 | 0.6563352461523513 | UWB
1782448652.649534 | 0xD0 | 0.6513047392873679 | 1.4266821181092917 | UWB
1782448653.0589533 | 0xD0 | 0.7222842674329866 | 1.54324328810265 | UWB
1782448655.2074866 | 0xD0 | 0.7143398697319649 | 2.0618204954213724 | UWB
1782448655.621331 | 0xD0 | 0.6604986937840426 | 2.2723258685419315 | UWB
1782448656.636723 | 0xD0 | 0.7761605516249586 | 2.341874274781343 | UWB
1782448657.3644707 | 0xD0 | 0.746132016407631 | 2.6608144317818994 | UWB
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
