HaiVuQuang/IPS_Firefighting_training_system/(list of files, drawings)

Other design files:
Hardware/PCB_Project_UWB/Beacon_V1.PcbDoc
Hardware/PCB_Project_UWB/Beacon_V2.PcbDoc
Hardware/PCB_Project_UWB/Beacon_V2.SchDoc
Hardware/PCB_Project_UWB/Beacon_V3.PcbDoc
Hardware/PCB_Project_UWB/PCB1.PcbDoc
Hardware/PCB_Project_UWB/PCB_Project_UWB.PrjPcb
Hardware/PCB_Project_UWB/Project Outputs for PCB_Project_UWB/PCB_Project_UWB/Beacon_V1.PcbDoc
Hardware/PCB_Project_UWB/Project Outputs for PCB_Project_UWB/PCB_Project_UWB/Beacon_V1.SchDoc
Hardware/PCB_Project_UWB/Project Outputs for PCB_Project_UWB/PCB_Project_UWB/PCB_Project_UWB.PrjPcb
Hardware/UWB_kit_prj/UWB_kit_prj.PrjPcb
Hardware/UWB_kit_prj/V2.PcbDoc
Hardware/UWB_kit_prj/V2.SchDoc
Hardware/UWB_Tag/UWB_Tag.PrjPcb
Hardware/UWB_Tag/UWB_Tag.SchDoc
Hardware/UWB_Tag/UWB_Tag_V1.PcbDoc
