HaiVuQuang/IPS_Firefighting_training_system/(commit log)

2026-03-24 Update UWB app and DW1000 driver for SS-TWR ranging
2026-04-26 Modify and optimize uwb ranging firmware. Initial commit for Tag Central MCU (ESP32) firmware.
2026-05-02 update TFT UI & optimizing frame
2026-05-02 Add device management feature
2026-05-25 Update Sensor Fusion (PDR + CNN)
2026-06-25 Update Server Final_v1
    [rssi_preprocess_raw_map_3.csv, trajectory_log.csv]
2026-06-26 Update Server Final v2
    [trajectory_log.csv]
2026-06-28 Update server final
    [map_17_26_06_2026_14_23_27.csv, trajectory_log.csv]
2026-07-31 Update ver Final
    [rssi_preprocess_raw_map_3.csv, trajectory_log.csv]
2026-08-05 Hardware & PCB
    [Beacon_V1.GBL, Beacon_V1.GBO, Beacon_V1.GBP, Beacon_V1.GBS, Beacon_V1.GTL, Beacon_V1.GTO, Beacon_V1.GTP, Beacon_V1.GTS]
